sdsmt-robotics/WSPEC-26-27/Controls/README.md

Sensor list  
Optical Sensors - We are using the PAW3395 mouse sensor
Rotary encoders - We are using the E6A2 
IMU  
Limit switches
