sdsmt-robotics/WSPEC-26-27/Mechanical/CADs/Full Assembly.SLDASM

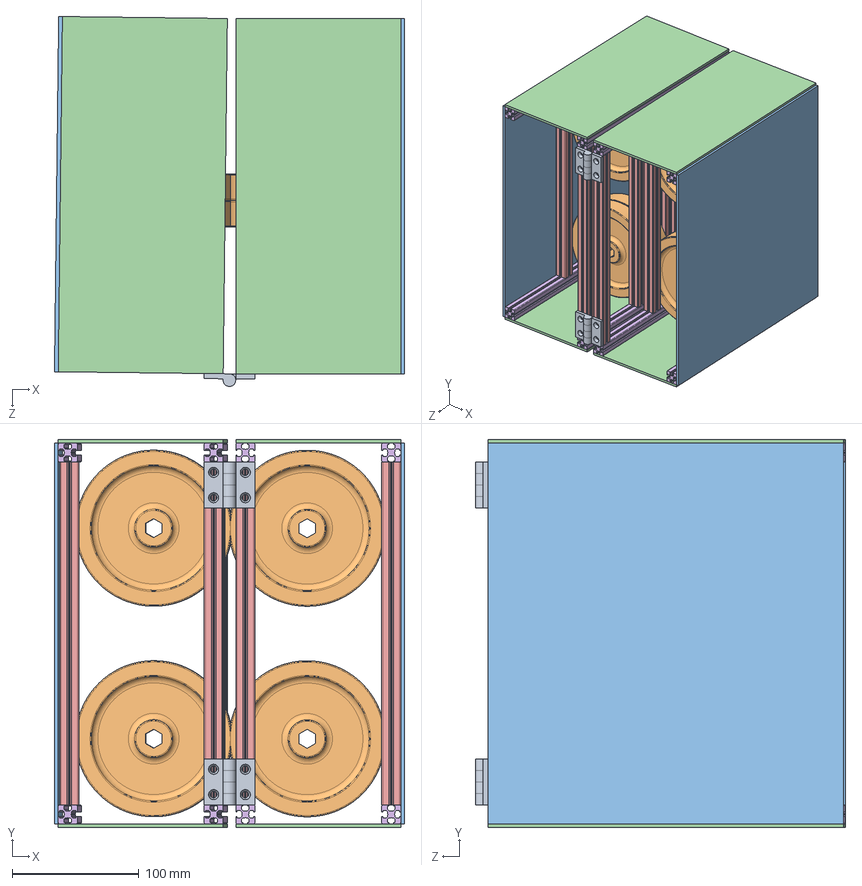
[picture p1: CAD file, 2026-11-12]
Mechanical/CADs/Full Assembly.SLDASM
275.9 x 306.0 x 291.6 mm
260mm Extrusion x 8
270mm Extrusion x 10
3x260x130 panel x 4
3x260x300 panel x 2
wheel x 8
hinge part 1 x 4
