sdsmt-robotics/WSPEC-26-27/Electrical/Controller PCB/Transmitter Board - Robotics/LCD1602/LCD1602.step

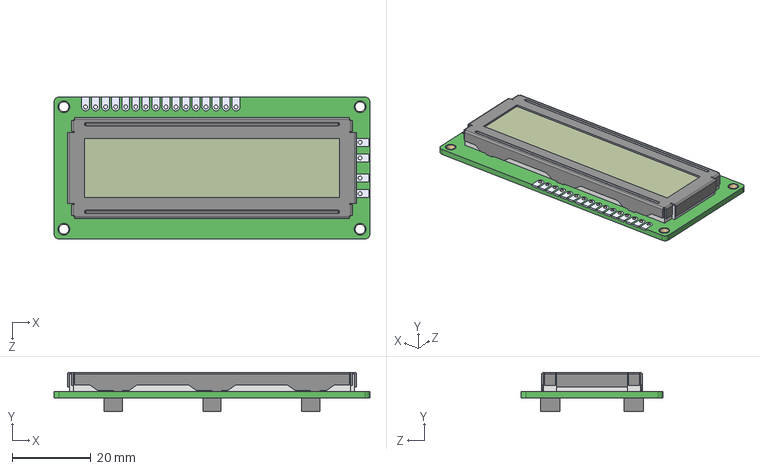
[picture p2: CAD file, 2026-10-22]
Electrical/Controller PCB/Transmitter Board - Robotics/LCD1602/LCD1602.step
80.0 x 10.0 x 36.0 mm
