sdsmt-robotics/WSPEC-26-27/Electrical/Power Distribution/Space Elevator Power Distributation Board/Components/BSS138/BSS138.step

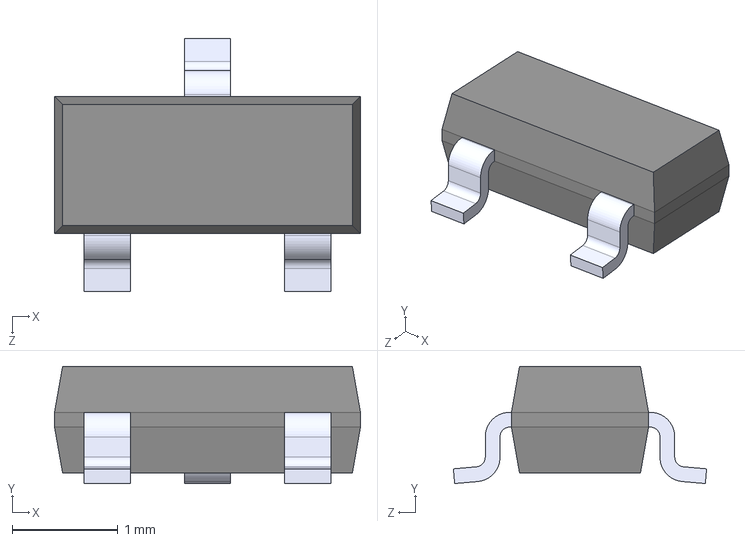
[picture p3: CAD file, 2026-11-05]
Electrical/Power Distribution/Space Elevator Power Distributation Board/Components/BSS138/BSS138.step
2.90 x 1.11 x 2.40 mm
