sdsmt-robotics/WSPEC-26-27/Mechanical/3D Printing/STL/Payload with extra tolerance.STL

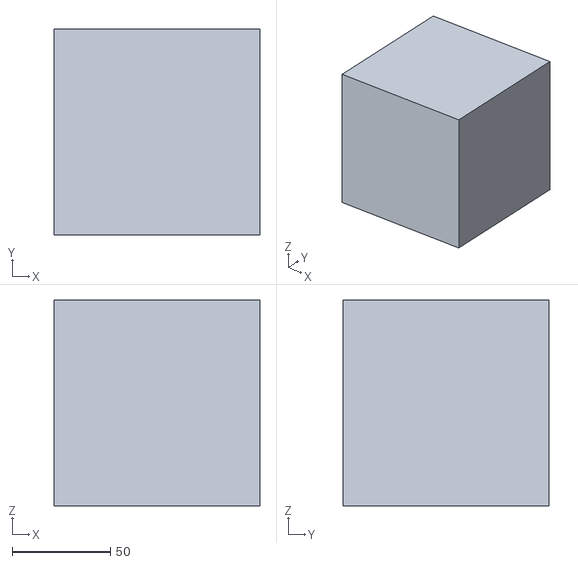
[picture p4: CAD file, 2026-10-22]
Mechanical/3D Printing/STL/Payload with extra tolerance.STL
105.0 x 105.0 x 105.0
