sdsmt-robotics/WSPEC-26-27/Mechanical/hinge part 1.SLDPRT

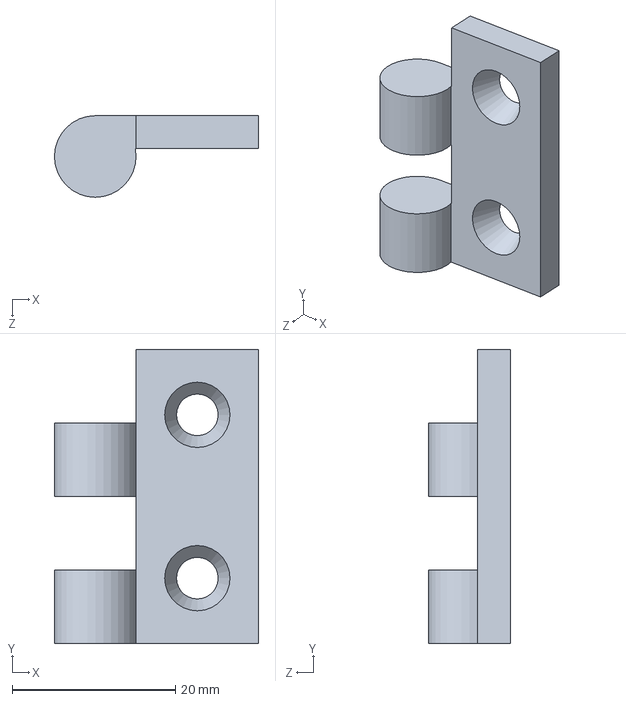
[picture p5: CAD file, 2026-10-15]
Mechanical/hinge part 1.SLDPRT
25.0 x 36.0 x 10.00 mm
