sdsmt-robotics/WSPEC-26-27/Mechanical/CADs/Back pannel.SLDPRT

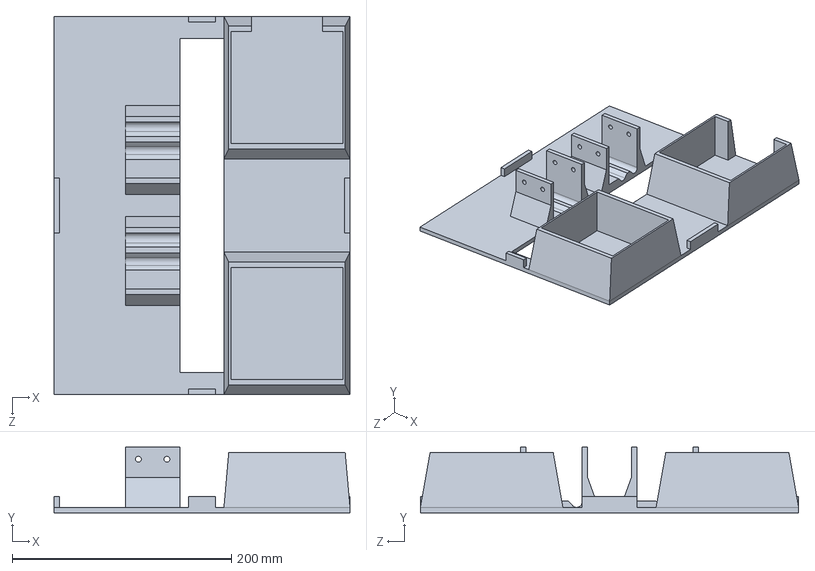
[picture p6: CAD file, 2026-11-12]
Mechanical/CADs/Back pannel.SLDPRT
270.0 x 60.0 x 345.0 mm
