sdsmt-robotics/WSPEC-26-27/Mechanical/CADs/motor mount tension.STL

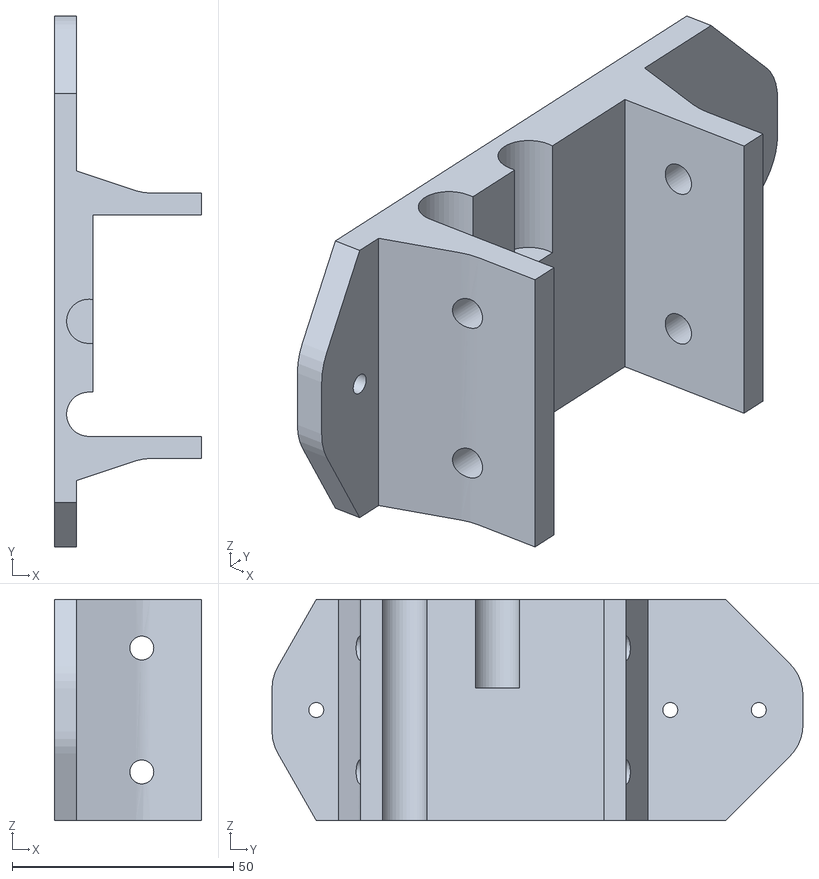
[picture p7: CAD file, 2026-11-12]
Mechanical/CADs/motor mount tension.STL
33.2 x 120.0 x 50.0
