sdsmt-robotics/WSPEC-26-27/Mechanical/CADs/Bearing.SLDPRT

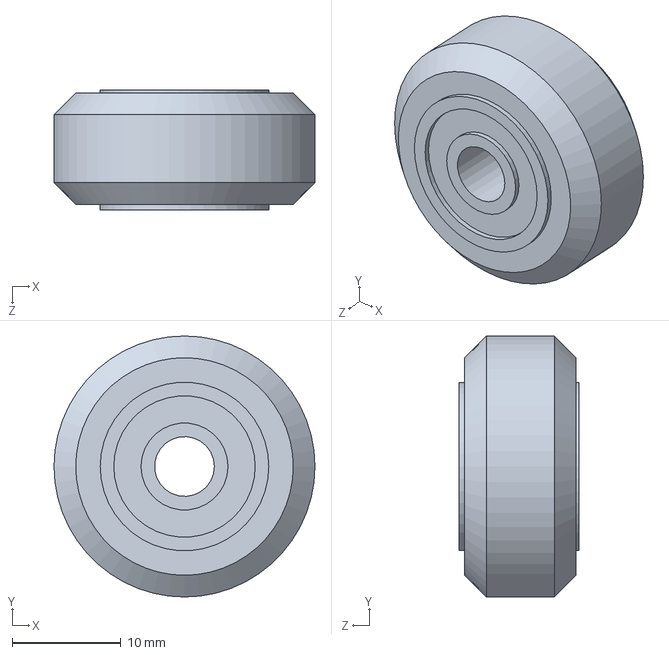
[picture p8: CAD file, 2026-11-07]
Mechanical/CADs/Bearing.SLDPRT
24.0 x 24.0 x 11.0 mm
