sdsmt-robotics/WSPEC-26-27/Mechanical/CADs/Wire Mounting for Prototype (20mm T-Slot).SLDPRT

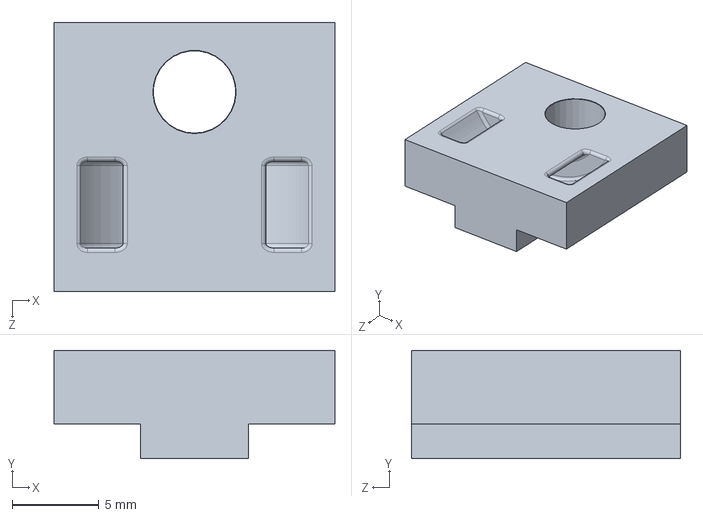
[picture p9: CAD file, 2026-11-05]
Mechanical/CADs/Wire Mounting for Prototype (20mm T-Slot).SLDPRT
16.2 x 6.25 x 15.5 mm
