sdsmt-robotics/WSPEC-26-27/Mechanical/CADs/Wheel_Axle_Bracket.SLDPRT

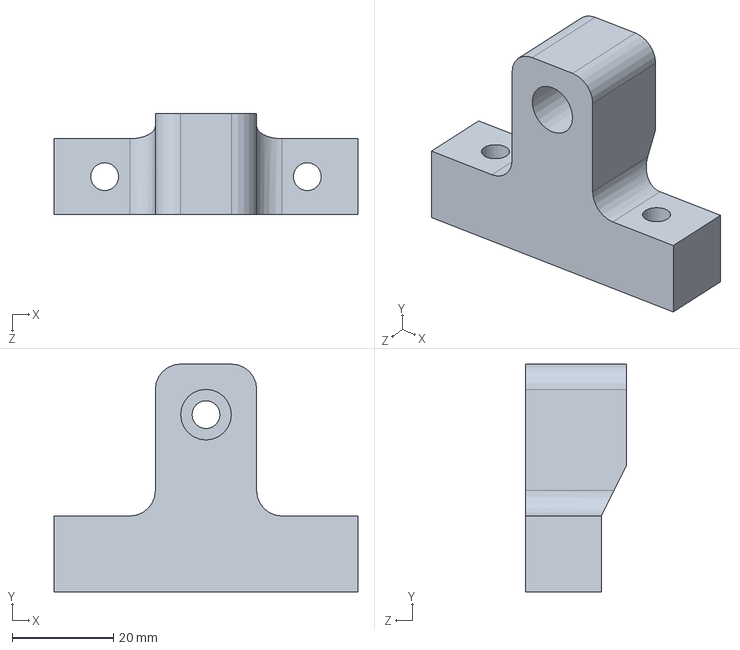
[picture p10: CAD file, 2026-11-05]
Mechanical/CADs/Wheel_Axle_Bracket.SLDPRT
60.0 x 45.0 x 20.0 mm
