sdsmt-robotics/WSPEC-26-27/Mechanical/CADs/100mm wheel.SLDPRT

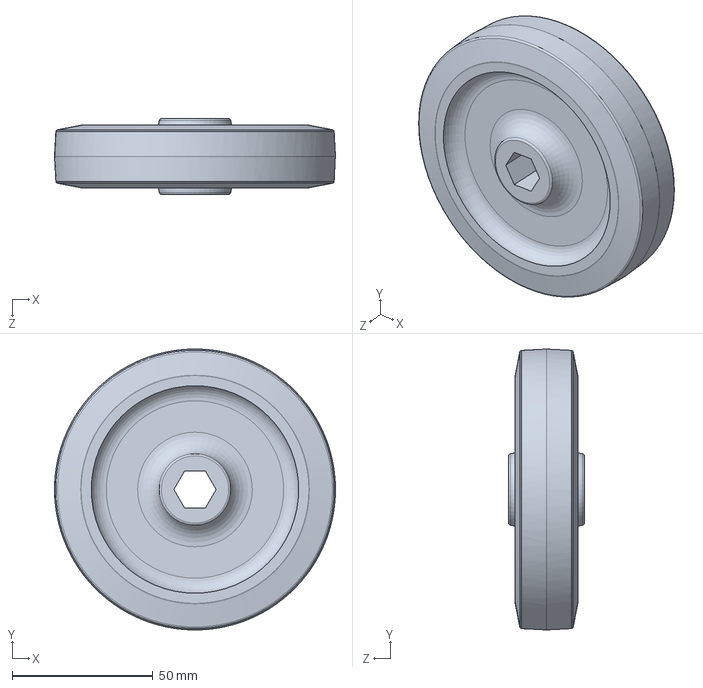
[picture p11: CAD file, 2026-11-05]
Mechanical/CADs/100mm wheel.SLDPRT
100.0 x 100.0 x 27.0 mm
