sdsmt-robotics/WSPEC-26-27/Mechanical/CADs/wheel.SLDPRT

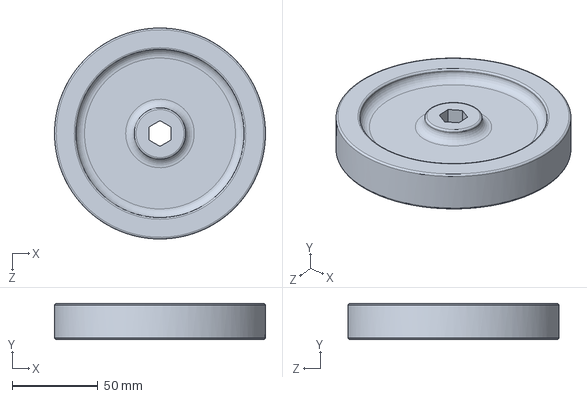
[picture p12: CAD file, 2026-10-17]
Mechanical/CADs/wheel.SLDPRT
123.0 x 21.0 x 123.0 mm
