sdsmt-robotics/WSPEC-26-27/Mechanical/CADs/3x260x130 panel.SLDPRT

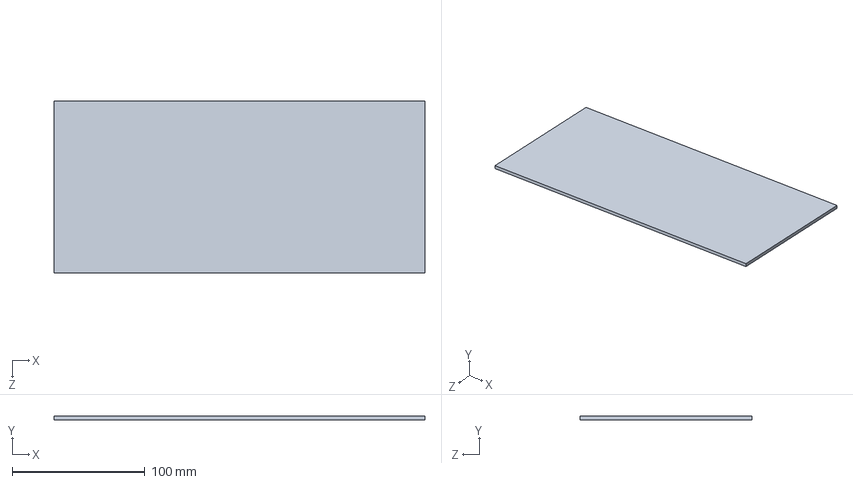
[picture p13: CAD file, 2026-10-15]
Mechanical/CADs/3x260x130 panel.SLDPRT
280.0 x 3.00 x 130.0 mm
