sdsmt-robotics/WSPEC-26-27/Mechanical/CADs/3x260x300 panel.SLDPRT

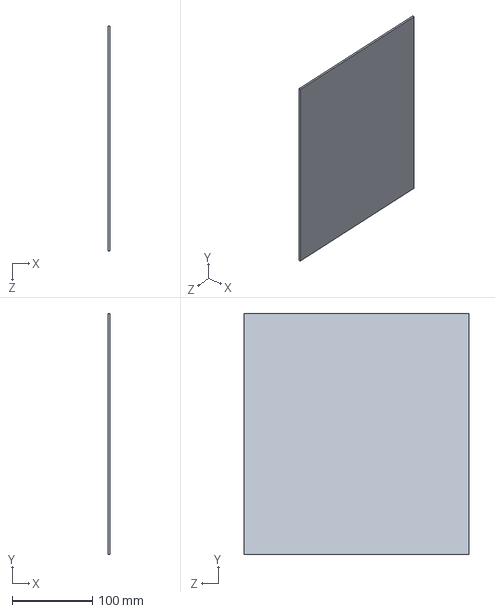
[picture p14: CAD file, 2026-10-15]
Mechanical/CADs/3x260x300 panel.SLDPRT
3.00 x 300.0 x 280.0 mm
