sdsmt-robotics/WSPEC-26-27/Mechanical/CADs/260mm Extrusion.SLDPRT

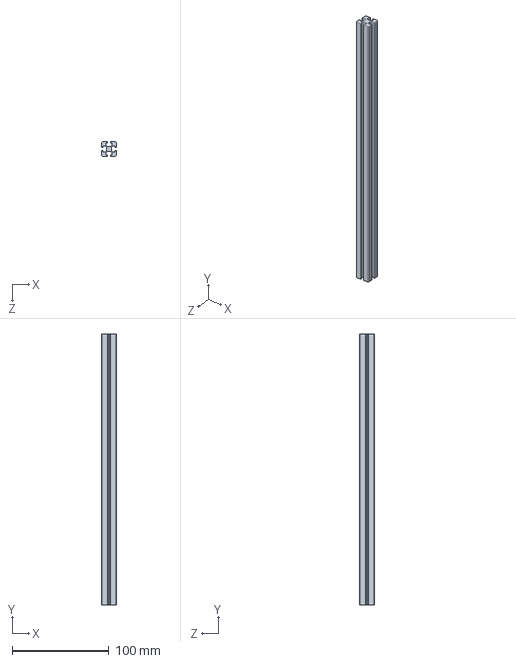
[picture p15: CAD file, 2026-10-15]
Mechanical/CADs/260mm Extrusion.SLDPRT
15.0 x 280.0 x 15.0 mm
