sdsmt-robotics/WSPEC-26-27/Mechanical/CADs/270mm Extrusion.SLDPRT

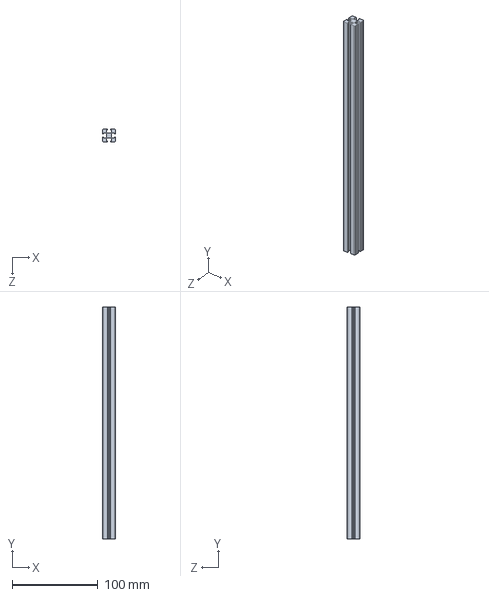
[picture p16: CAD file, 2026-10-14]
Mechanical/CADs/270mm Extrusion.SLDPRT
15.0 x 270.0 x 15.0 mm
