sdsmt-robotics/WSPEC-26-27/Mechanical/CADs/spaceelevatorwheel.SLDPRT

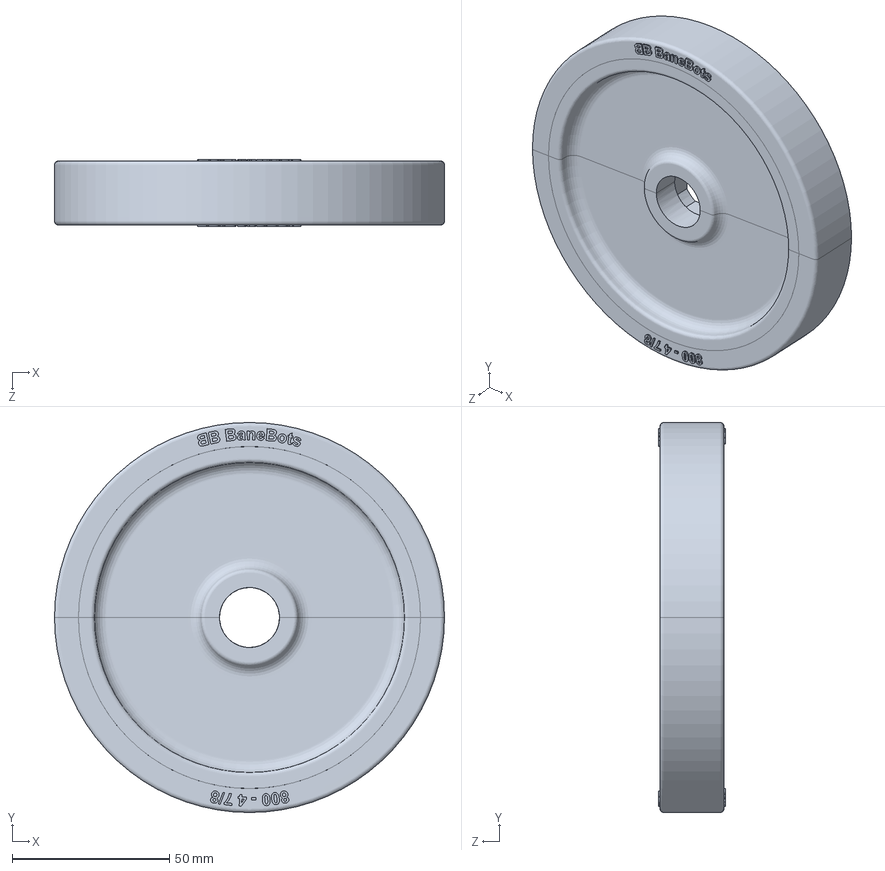
[picture p17: CAD file, 2026-10-10]
Mechanical/CADs/spaceelevatorwheel.SLDPRT
123.8 x 123.8 x 21.3 mm
