sdsmt-robotics/WSPEC-26-27/Mechanical/CADs/Payload/New Assembly.SLDASM

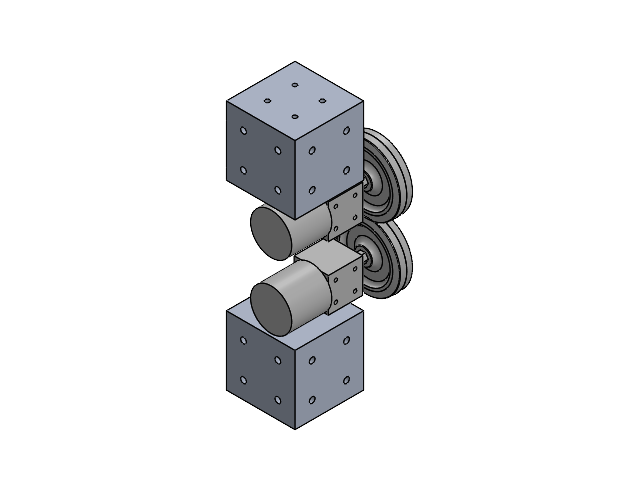
[picture p19: CAD file, 2026-11-05]
Mechanical/CADs/Payload/New Assembly.SLDASM
Neo211650MotorBox x 2
NeoMotorHexShaft x 2
100mm wheel x 2
Payload Cube x 2
