sdsmt-robotics/WSPEC-26-27/Mechanical/CADs/Frame Assembly.SLDASM

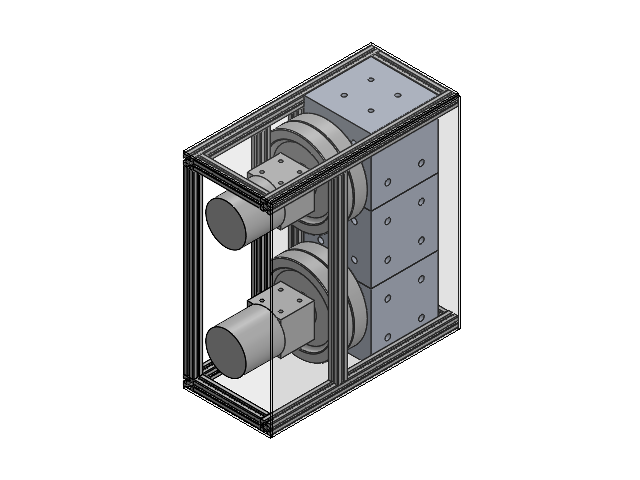
[picture p20: CAD file, 2026-10-17]
Mechanical/CADs/Frame Assembly.SLDASM
100mm Extrusion x 4
260mm Extrusion x 4
270mm Extrusion x 5
Neo211650MotorBox x 2
NeoMotorHexShaft x 2
3x260x130 panel x 2
3x260x300 panel
Payload Cube x 3
wheel x 4
