sdsmt-robotics/WSPEC-26-27/(list of files, cad)

Other CAD files:
Mechanical/CADs/Extrusion Sketch.SLDPRT
Mechanical/CADs/Neo211650Motor.SLDASM
Mechanical/CADs/Neo211650MotorBox.SLDPRT
Mechanical/CADs/Wire Mounting for Prototype (20mm T-Slot).STL
