sdsmt-robotics/WSPEC-26-27/Electrical/Controller PCB/Outputs/ControllerSch.pdf

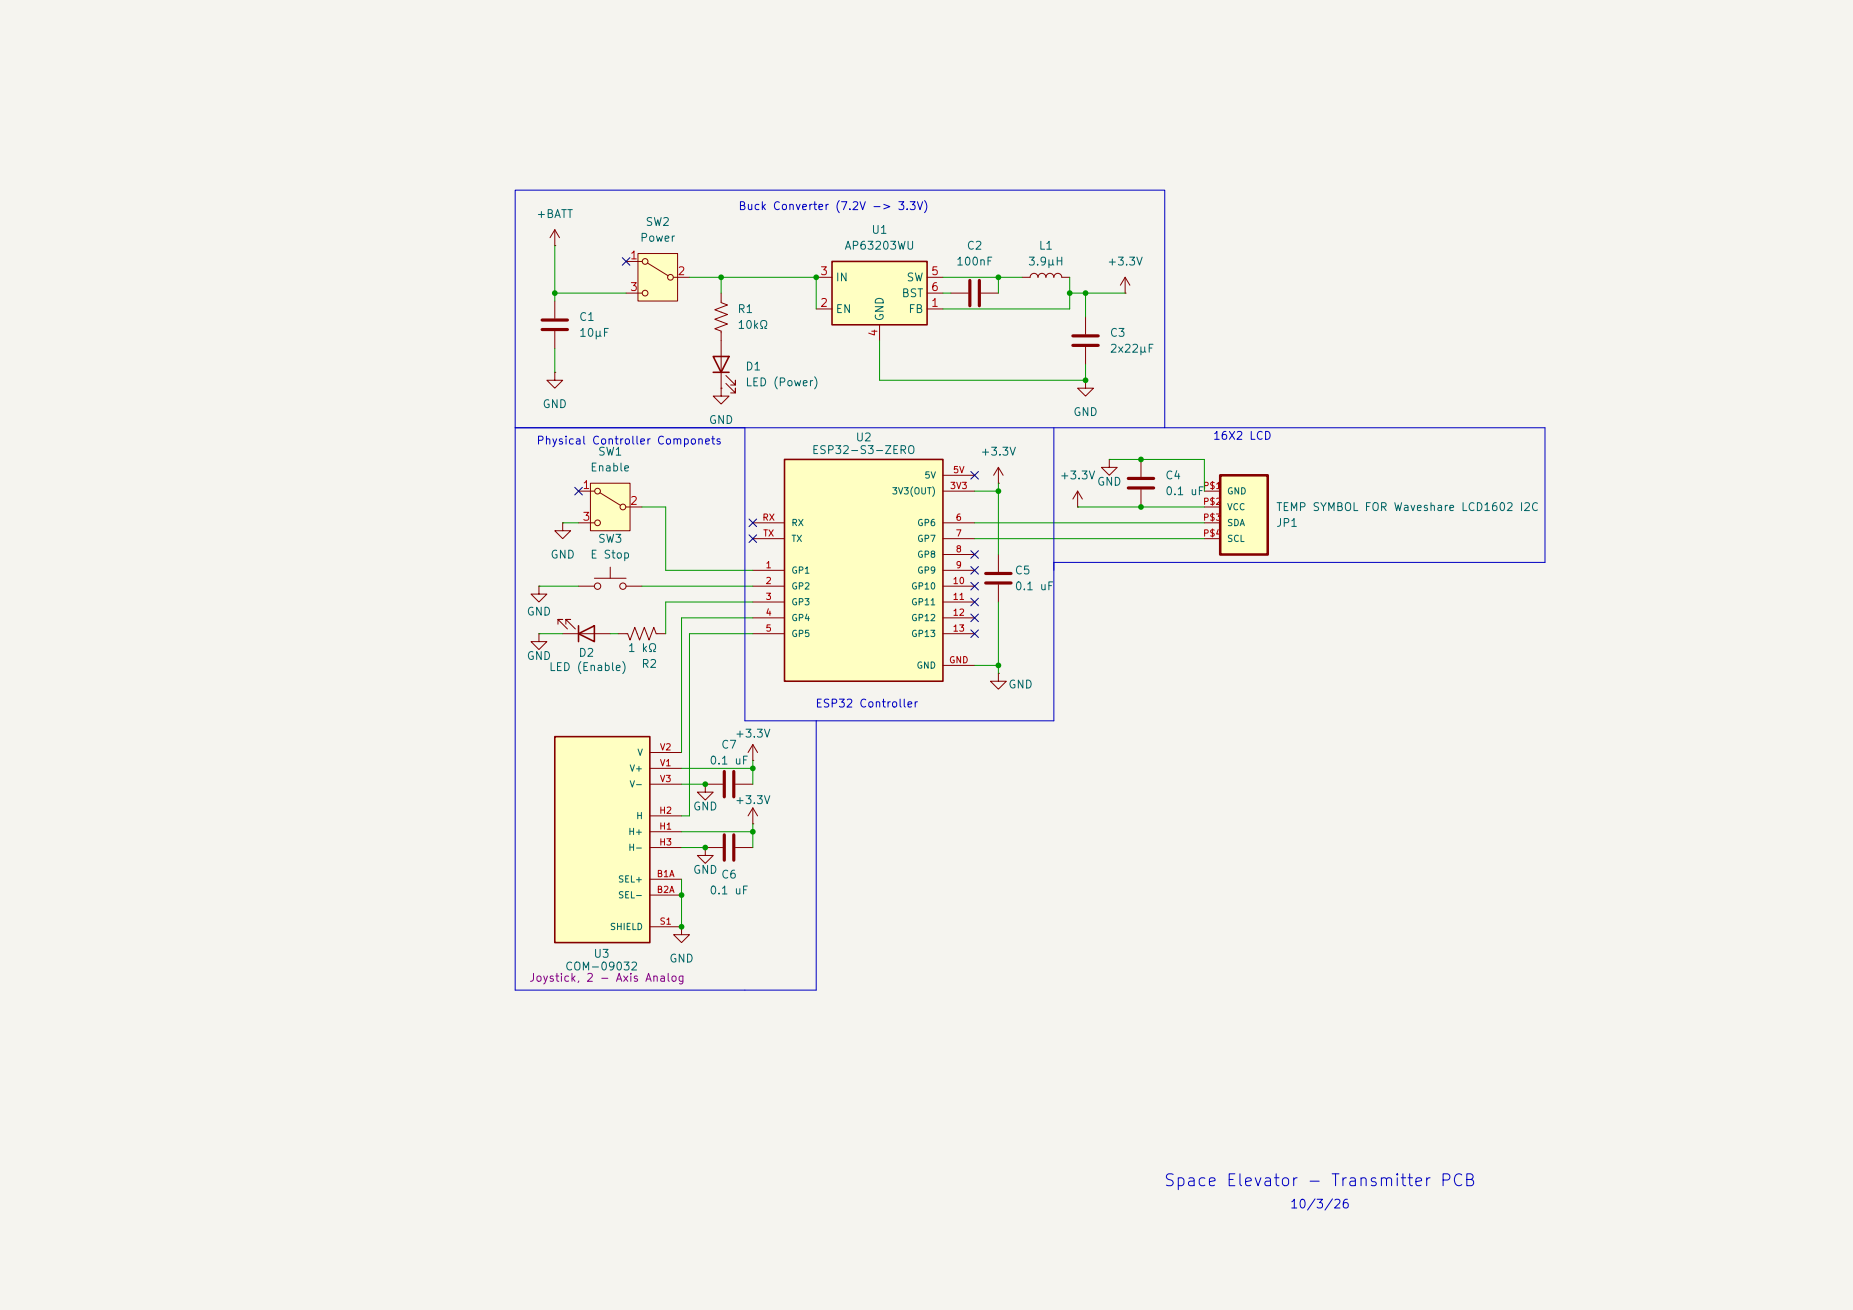
[picture p21: page 1]
