sdsmt-robotics/WSPEC-26-27/Electrical/mainControl/Outputs/mainControlSch.pdf

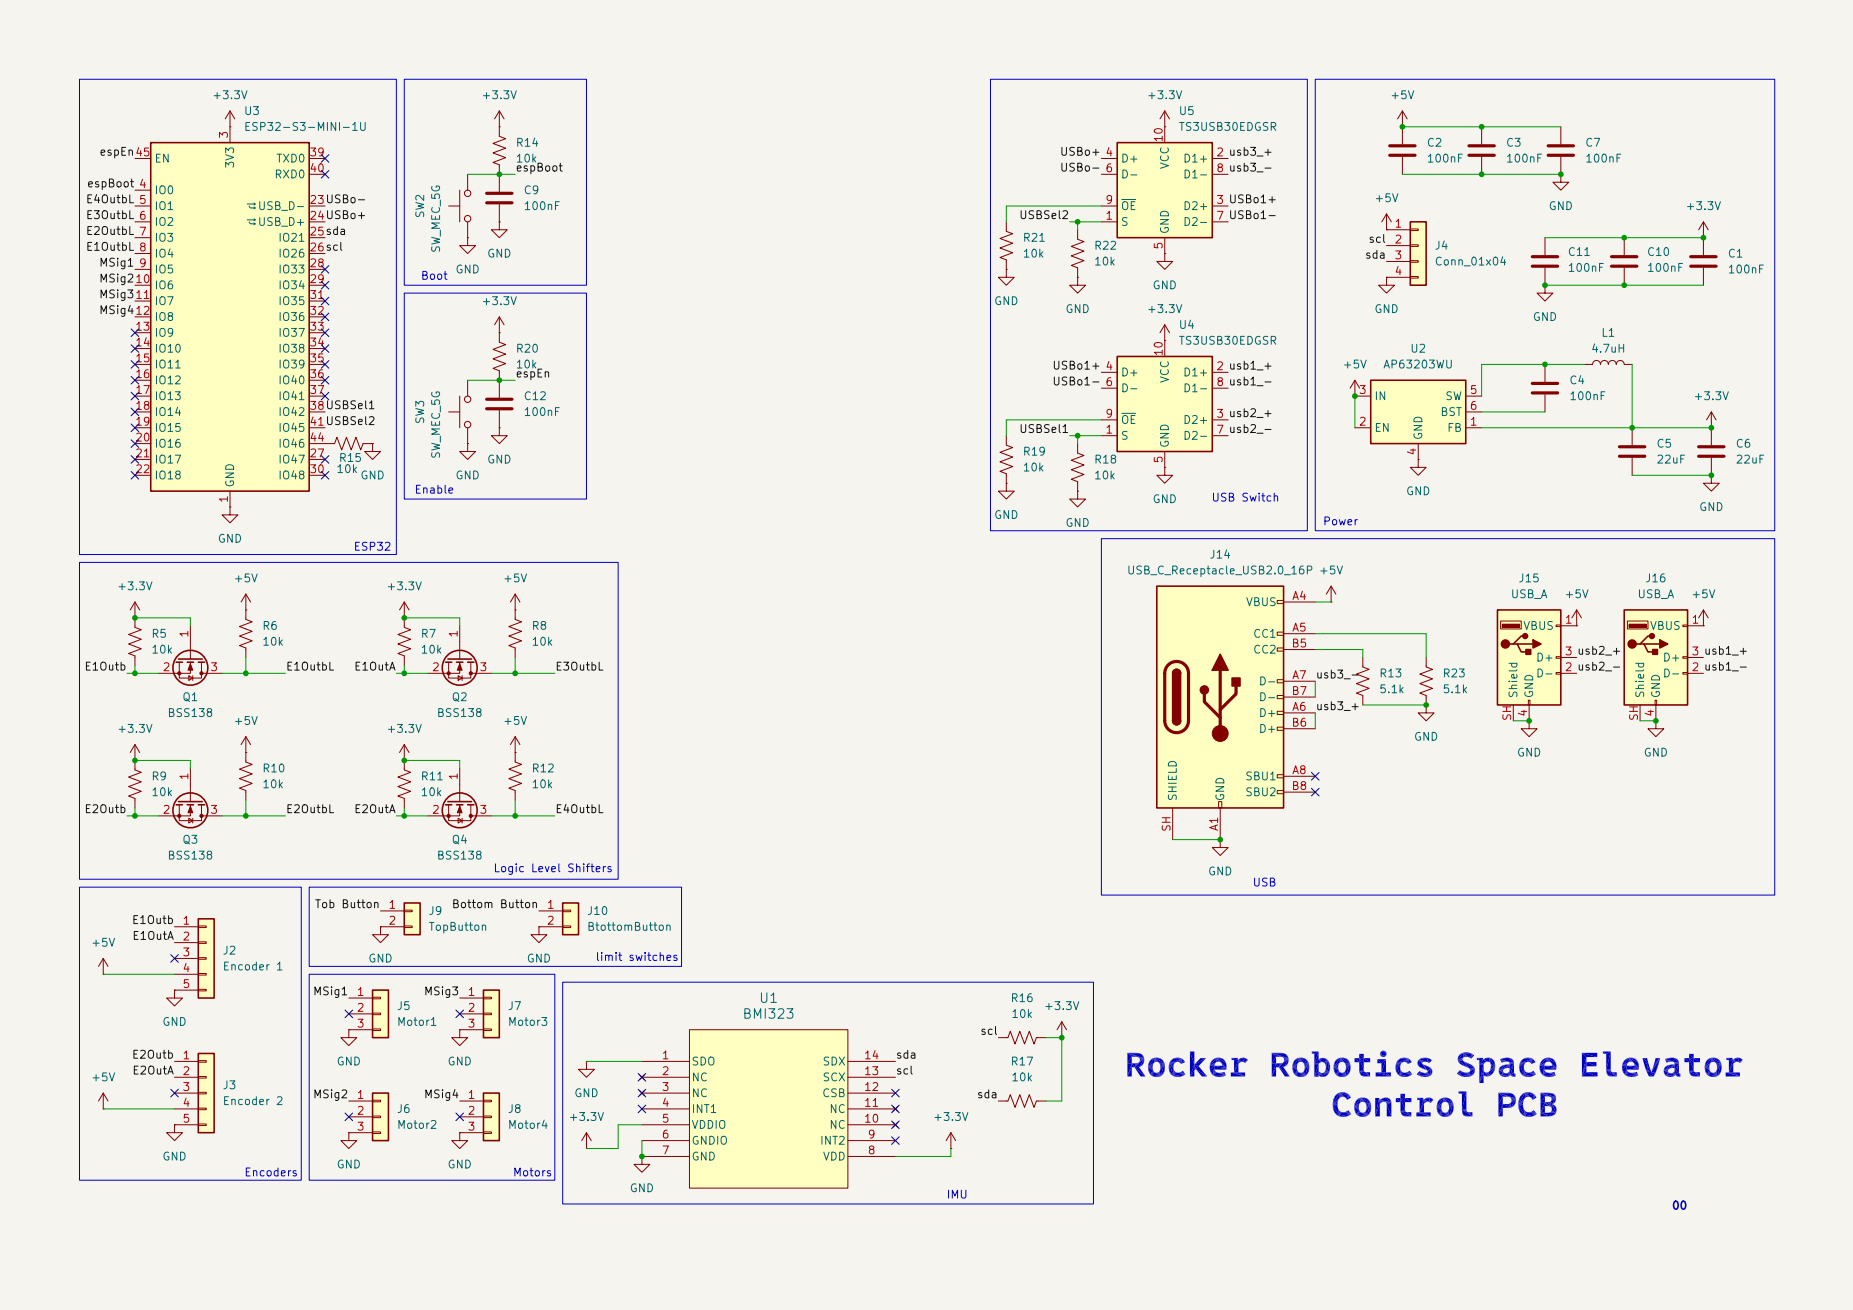
[picture p22: page 1]
