sdsmt-robotics/WSPEC-26-27/Electrical/Controller PCB/Transmitter Board - Robotics/transmitter_board/transmitter_board.kicad_pcb

## KiCad design Electrical/Controller PCB/Transmitter Board - Robotics/transmitter_board/transmitter_board.kicad_pcb (2026-11-14)

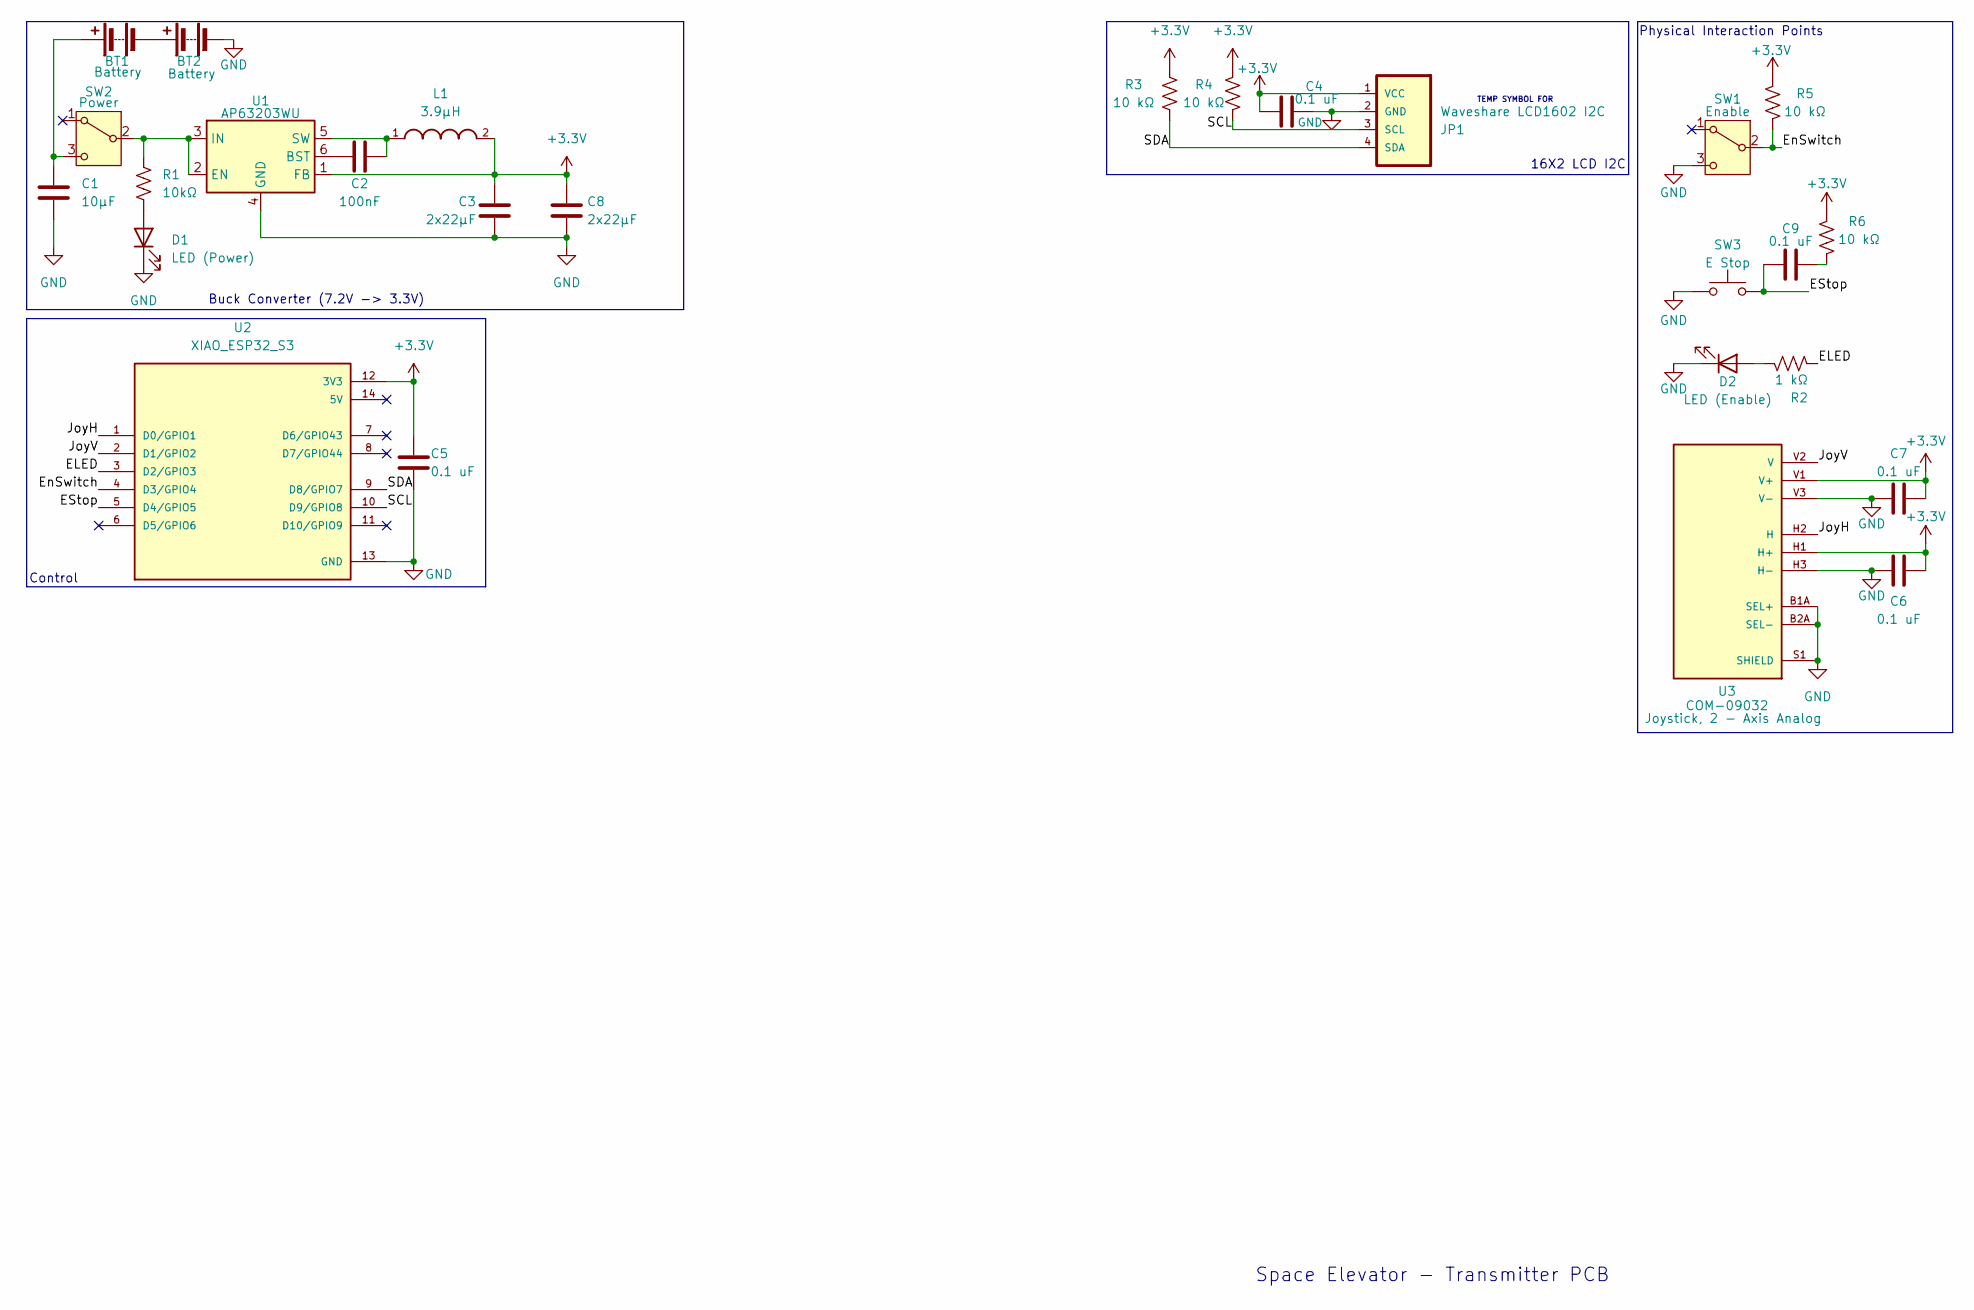
[picture p23: schematic transmitter_board.kicad_sch]

Parts:
BT1, BT2: Battery; BatteryHolder_Keystone_1042_1x18650
C1: 10µF; C_0805_2012Metric
C2: 100nF; C_0805_2012Metric
C3, C8: 2x22µF; C_0805_2012Metric
C4, C5, C6, C7, C9: 0.1 uF; C_0805_2012Metric
D1: LED (Power); LED_D4.0mm
D2: LED (Enable); LED_D4.0mm
JP1: Waveshare LCD1602 I2C; JST_PH_S4B-PH-K_1x04_P2.00mm_Horizontal
L1: 3.9µH; INDC0603X33N; DigiKey_Part_Number 490-6730-1-ND
R1: 10kΩ; R_0805_2012Metric
R2: 1 kΩ; R_0805_2012Metric
R3, R4, R5, R6: 10 kΩ; R_0805_2012Metric
SW1: Enable; SS12SDP2_NKK
SW2: Power; SS12SDP2_NKK
SW3: E Stop; SW_800AWSP9M2QE
U1: AP63203WU; TSOT-23-6
U2: XIAO_ESP32_S3; MODULE_XIAO_ESP32_S3; PARTREV April 22nd, 2026
U3: COM-09032; XDCR_COM-09032; PARTREV N/A

Connections:
+3.3V: C3.1, C4.1, C5.1, C6.2, C7.2, C8.1, JP1.1 (VCC), L1.2, R3.2, R4.1, R5.2, R6.2, U1.1 (FB), U2.12 (3V3), U3.H1 (H+), U3.V1 (V+)
/ELED: R2.2, U2.3 (D2/GPIO3)
/EStop: C9.1, SW3.2, U2.5 (D4/GPIO5)
/EnSwitch: R5.1, SW1.2 (B), U2.4 (D3/GPIO4)
/JoyH: U2.1 (D0/GPIO1), U3.H2 (H)
/JoyV: U2.2 (D1/GPIO2), U3.V2 (V)
/SCL: JP1.3 (SCL), R4.2, U2.10 (D9/GPIO8)
/SDA: JP1.4 (SDA), R3.1, U2.9 (D8/GPIO7)
GND: BT2.2 (-), C1.2, C3.2, C4.2, C5.2, C6.1, C7.1, C8.2, D1.1 (K), D2.1 (K), JP1.2 (GND), SW1.3 (C), SW3.1, U1.4 (GND), U2.13 (GND), U3.B1A (SEL+), U3.B2A (SEL-), U3.H3 (H-), U3.S1 (SHIELD), U3.S2 (SHIELD), U3.S3 (SHIELD), U3.S4 (SHIELD), U3.V3 (V-)
unnamed: BT1.1 (+), C1.1, SW2.3 (C)
unnamed: BT1.2 (-), BT2.1 (+)
unnamed: C9.2, R6.1
unnamed: D1.2 (A), R1.2
unnamed: D2.2 (A), R2.1
unnamed: R1.1, SW2.2 (B), U1.2 (EN), U1.3 (IN)
unnamed: C2.1, U1.6 (BST)
unnamed: C2.2, L1.1, U1.5 (SW)

Notes on the sheet:
Physical Interaction Points
16X2 LCD I2C
Buck Converter (7.2V -> 3.3V)
TEMP SYMBOL FOR
Space Elevator - Transmitter PCB
Control

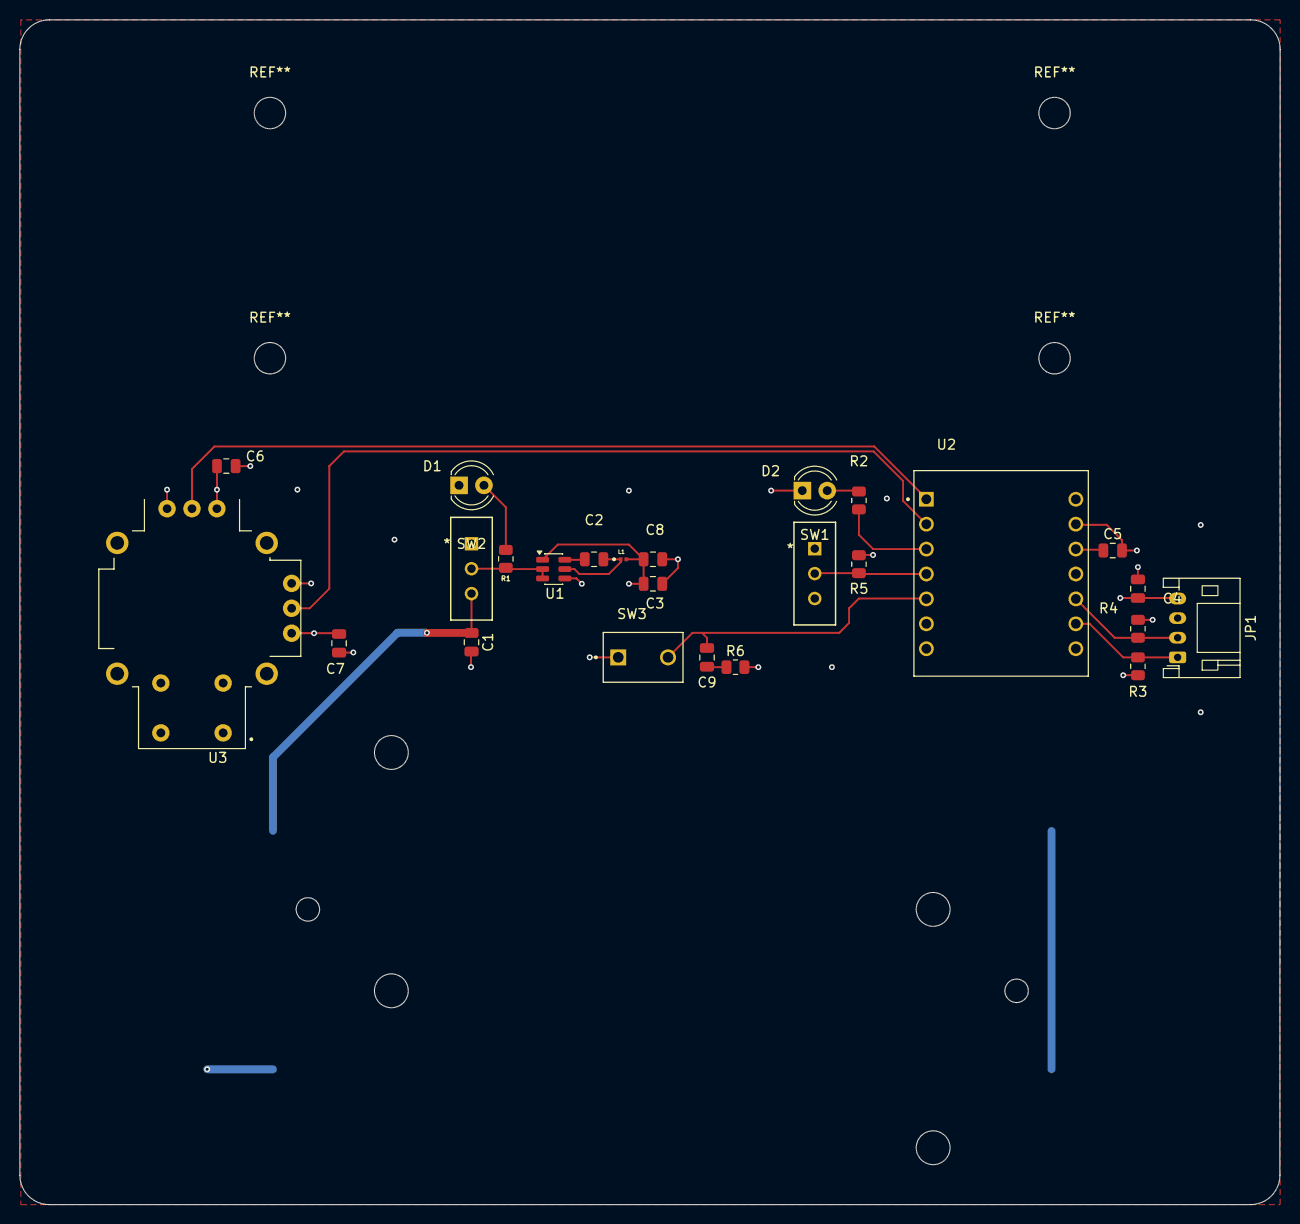
[picture p24: board transmitter_board.kicad_pcb from above]

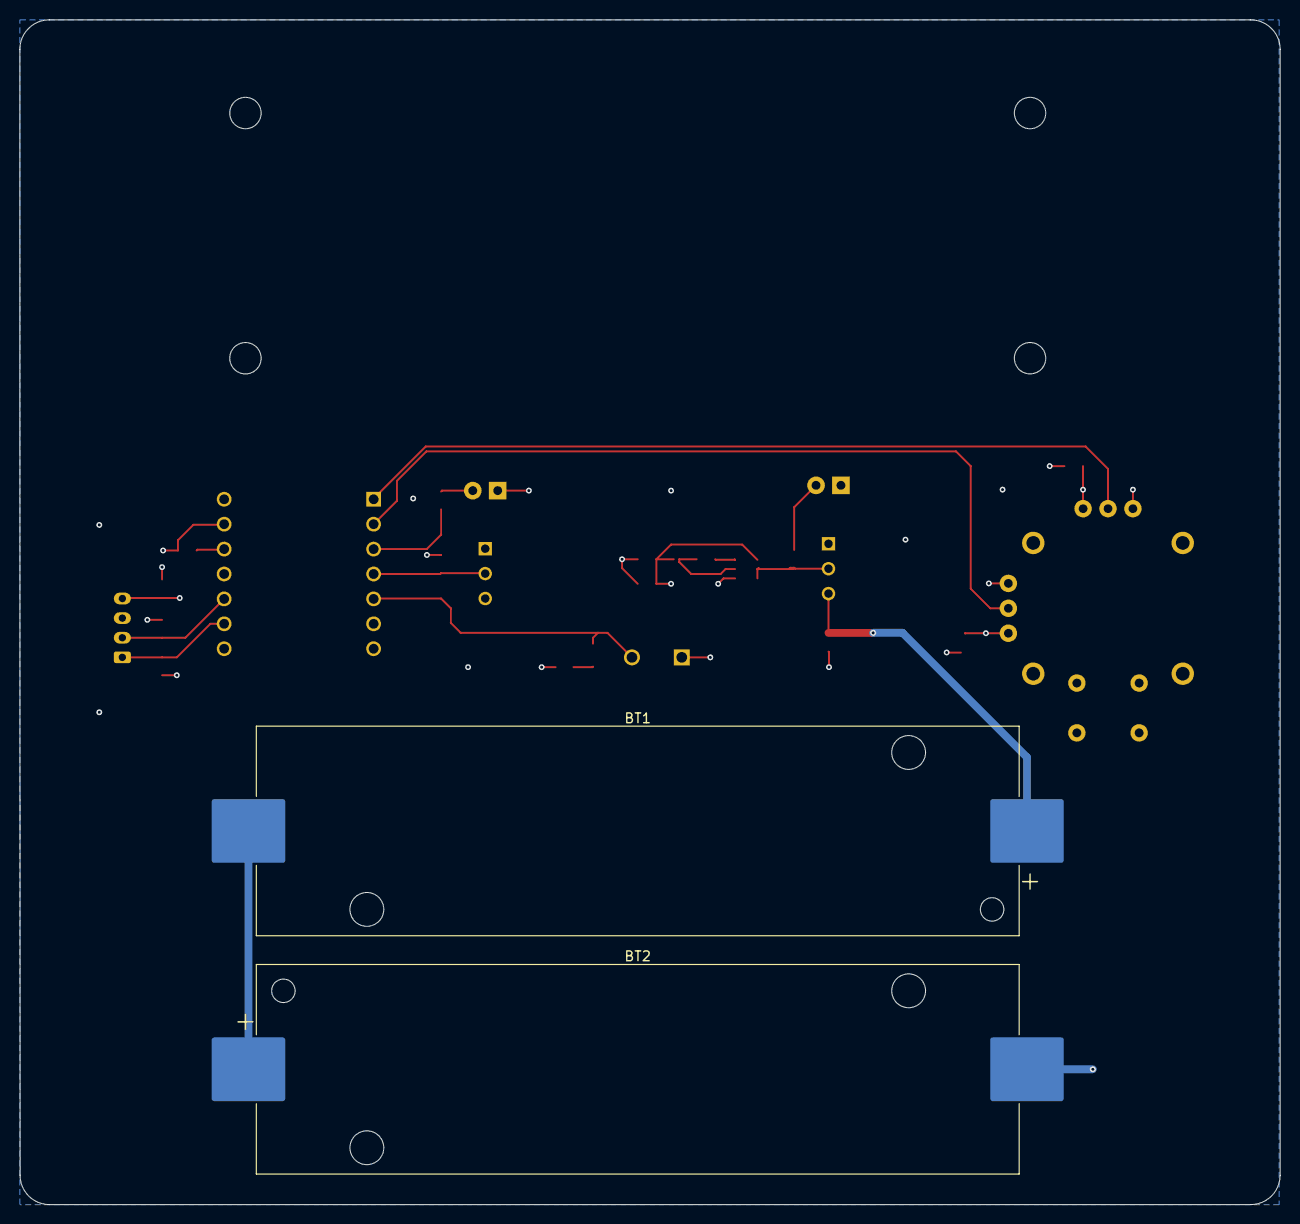
[picture p25: board transmitter_board.kicad_pcb from below]

Board: 4 copper layers, 128.5 x 120.8 mm, 27 parts (2 on the bottom side), 17 nets.
