sdsmt-robotics/WSPEC-26-27/Electrical/mainControl/SEControlBoard.kicad_pcb

## KiCad design Electrical/mainControl/SEControlBoard.kicad_pcb (2026-10-22)

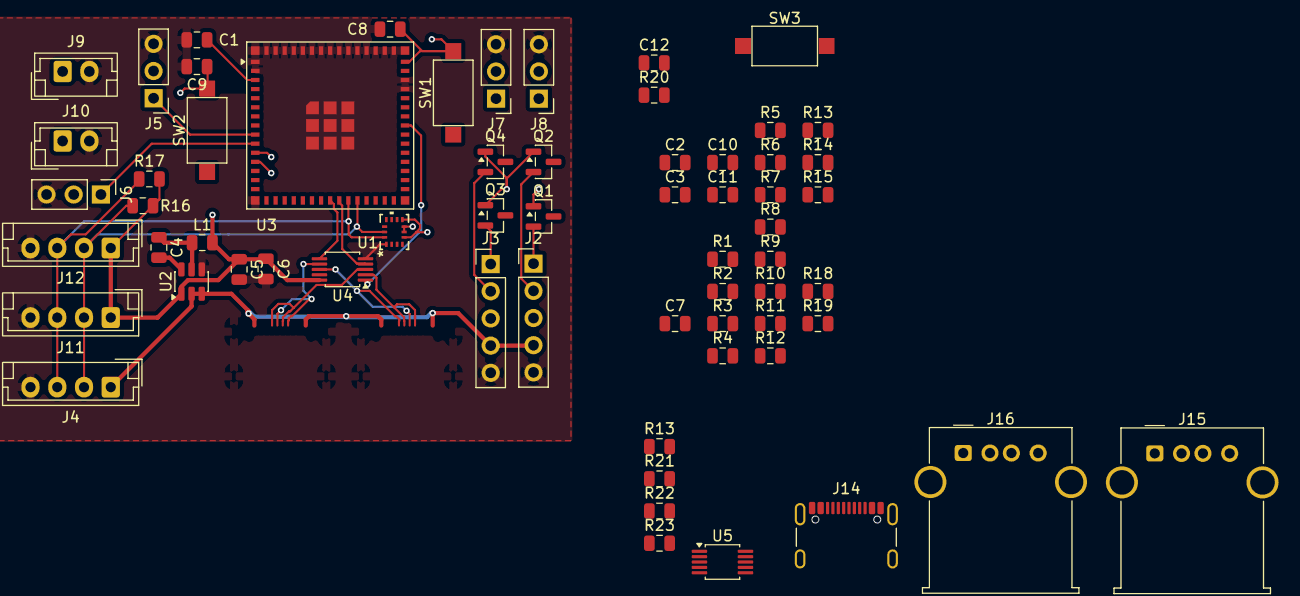
[picture p26: board SEControlBoard.kicad_pcb from above]

Board: 4 copper layers, 63 parts (0 on the bottom side), 38 nets.

Parts:
C1, C2, C3, C4, C7, C8, C9, C10, C11, C12: 100nF; C_0805_2012Metric
C5, C6: 22uF; C_0805_2012Metric
J2: Encoder 1; PinHeader_1x05_P2.54mm_Vertical
J3: Encoder 2; PinHeader_1x05_P2.54mm_Vertical
J4: Conn_01x04; JST_EH_B4B-EH-A_1x04_P2.50mm_Vertical
J5: Motor1; PinHeader_1x03_P2.54mm_Vertical
J6: Motor2; PinHeader_1x03_P2.54mm_Vertical
J7: Motor3; PinHeader_1x03_P2.54mm_Vertical
J8: Motor4; PinHeader_1x03_P2.54mm_Vertical
J9: TopButton; JST_EH_B2B-EH-A_1x02_P2.50mm_Vertical
J10: BtottomButton; JST_EH_B2B-EH-A_1x02_P2.50mm_Vertical
J11: Mouse1; JST_EH_B4B-EH-A_1x04_P2.50mm_Vertical
J12: Mouse2; JST_EH_B4B-EH-A_1x04_P2.50mm_Vertical
J14: USB_C_Receptacle_USB2.0_16P; USB_C_Receptacle_GCT_USB4105-xx-A_16P_TopMnt_Horizontal
J15, J16: USB_A; USB_A_Molex_67643_Horizontal
L1: 4.7uH; C_0805_2012Metric
Q1, Q2, Q3, Q4: BSS138; SOT-23
R1, R2, R3, R4, R13#2, R23: 5.1k; C_0805_2012Metric
R5, R6, R7, R8, R9, R10, R11, R12, R13, R14, R15, R16, R17, R18, R19, R20, R21, R22: 10k; C_0805_2012Metric
SW1, SW2, SW3: SW_MEC_5G; SW_SPST_CK_RS282G05A3
U1: BMI323; BMI323_BOS
U2: AP63203WU; TSOT-23-6
U3: ESP32-S3-MINI-1U; ESP32-S2-MINI-1U
U4, U5: TS3USB30EDGSR; TSSOP-10_3x3mm_P0.5mm

Connections:
+3.3V: C1.1, C5.1, C6.1, C8.1, C10.1, C11.1, J11.1, J12.1, L1.2, Q1.1 (G), Q2.1 (G), Q3.1 (G), Q4.1 (G), R5.2, R7.2, R9.2, R11.2, R14.2, R16.2, R17.2, R20.2, SW1.2 (B), U1.5 (VDDIO), U1.8 (VDD), U2.1 (FB), U3.3 (3V3), U4.10 (VCC), U5.10 (VCC)
+5V: C2.1, C3.1, C7.1, J2.4, J3.4, J4.1, J14.A4 (VBUS), J14.A9 (VBUS), J14.B4 (VBUS), J14.B9 (VBUS), J15.1 (VBUS), J16.1 (VBUS), R6.2, R8.2, R10.2, R12.2, U2.2 (EN), U2.3 (IN)
/E1OutA: J2.2, Q2.2 (S), R7.1
/E1Outb: J2.1, Q1.2 (S), R5.1
/E1OutbL: Q1.3 (D), R6.1, U3.8 (IO4)
/E2OutA: J3.2, Q4.2 (S), R11.1
/E2Outb: J3.1, Q3.2 (S), R9.1
/E2OutbL: Q3.3 (D), R10.1, U3.7 (IO3)
/E3OutbL: Q2.3 (D), R8.1, U3.6 (IO2)
/E4OutbL: Q4.3 (D), R12.1, U3.5 (IO1)
/MSig1: J5.1, U3.9 (IO5)
/MSig2: J6.1, U3.10 (IO6)
/MSig3: J7.1, U3.11 (IO7)
/MSig4: J8.1, U3.12 (IO8)
/USBSel: R18.2, R22.2, U3.38 (IO42), U4.1 (S), U5.1 (S)
/USBo1+: U4.4 (D+), U5.3 (D2+)
/USBo1-: U4.6 (D-), U5.7 (D2-)
/USBo+: U3.24 (USB_D+), U5.4 (D+)
/USBo-: U3.23 (USB_D-), U5.6 (D-)
/espBoot: C9.1, R14.1, SW2.2 (B), U3.4 (IO0)
/espEn: C12.1, R20.1, SW3.2 (B), U3.45 (EN)
/scl: J4.2, J11.2, J12.2, R16.1, U1.13 (SCX), U3.26 (IO26)
/sda: J4.3, J11.3, J12.3, R17.1, U1.14 (SDX), U3.25 (IO21)
/usb1_+: J16.3 (D+), U4.2 (D1+)
/usb1_-: J16.2 (D-), U4.8 (D1-)
/usb2_+: J15.3 (D+), U4.3 (D2+)
/usb2_-: J15.2 (D-), U4.7 (D2-)
/usb3_+: J14.A6 (D+), J14.B6 (D+), U5.2 (D1+)
/usb3_-: J14.A7 (D-), J14.B7 (D-), U5.8 (D1-)
GND: C1.2, C2.2, C3.2, C5.2, C6.2, C7.2, C8.2, C9.2, C10.2, C11.2, C12.2, J2.5, J3.5, J4.4, J5.3, J6.3, J7.3, J8.3, J9.2, J10.2, J11.4, J12.4, J14.A1 (GND), J14.A12 (GND), J14.B1 (GND), J14.B12 (GND), J14.SH (SHIELD), J15.4 (GND), J15.SH (Shield), J16.4 (GND), J16.SH (Shield), R1.2, R2.2, R3.2, R4.2, R13.1, R13#2.2, R15.2, R18.1, R19.1, R21.1, R22.1, R23.2, SW2.1 (A), SW3.1 (A), U1.1 (SDO), U1.6 (GNDIO), U1.7 (GND), U2.4 (GND), U3.1 (GND), U3.2 (GND), U3.42 (GND), U3.43 (GND), U3.46 (GND), U3.47 (GND), U3.48 (GND), U3.49 (GND), U3.50 (GND), U3.51 (GND), U3.52 (GND), U3.53 (GND), U3.54 (GND), U3.55 (GND), U3.56 (GND), U3.57 (GND), U3.58 (GND), U3.59 (GND), U3.60 (GND), U3.61 (GND), U3.62 (GND), U3.63 (GND), U3.64 (GND), U3.65 (GND), U4.5 (GND), U5.5 (GND)
unnamed: J14.A5 (CC1), R23.1
unnamed: J14.B5 (CC2), R13#2.1
unnamed: R13.2, SW1.1 (A)
unnamed: C4.2, U2.6 (BST)
unnamed: C4.1, L1.1, U2.5 (SW)
unnamed: R15.1, U3.44 (IO46)
unnamed: R19.2, U4.9 (~OE)
unnamed: R21.2, U5.9 (~OE)
