sdsmt-robotics/WSPEC-26-27/(commit log)

2026-09-26 Add sensor list to README
2026-09-26 Fix formatting of sensor list in README
2026-10-10 motor box, motor shaft, motor assembley
2026-10-14 Added frame assembly and panels
2026-10-14 Created extrusion files and a profile file to make desired lengths
2026-10-14 Added payload cube
    Payload cube with mounting holes added. The drawing appears to show the model as hollow so I did the same, DON'T rely on the hollowness. The mass is similar to what is defined in the drawing.
2026-10-15 made hinge part
2026-10-15 Started Frame assembly
2026-10-15 Started the full assemby and moved hinge into the CAD folder
2026-10-17 Added wheel
2026-10-18 Added linear bearing
2026-10-21 added power distribution board
2026-10-21 Putting Kicad schematics in electrical folder
2026-10-21 Create Dual Wheel Drive Adapter.SLDPRT
    Added a drive adapter to interface our motor to our wheels
2026-10-22 Initial Motor Code tests for both ppm method and UART
2026-10-22 changed arrangment in schematic
2026-10-22 added motor mount and payload cube with high tolerances
2026-10-22 Changes to power distribution schematic before PDR
2026-10-22 Schematic changes to transmitter PCB
2026-10-23 finished up init schematic
2026-10-24 Controller PCB updates
2026-10-24 Transmitter PCB Schematic updates
2026-10-25 Update motor mount tension.SLDPRT
2026-10-27 Update motor mount tension.SLDPRT
    Updated Motor Mounts
2026-10-27 Update motor mount tension.SLDPRT
    Update Measurements
2026-10-27 Update motor mount tension.SLDPRT
    Updated Motor Tensile Mounts again again again
2026-10-31 Create Wheel_Axle_Bracket.SLDPRT
    Create a new bracket to hold the axle (screws) that hold the wheels on.
2026-10-31 rotary encoder mount
2026-10-31 Update rotary encoder mount.SLDPRT
2026-11-05 Wire Mounting for 20mm T-Slot
    Ziptie t-slot mounts for mounting wires as cheaply and lightly as possible
2026-11-05 Started new assembly after rule change
2026-11-07 moved main assembly
2026-11-07 added the bearing
2026-11-12 Updated assembly
    Updated assembly
2026-11-14 Transmitter PCB changes
2026-11-14 Transmitter PCB updates
